pommen/raspi_power_hat/SMPS hat production V1/SMPS hat/prod/SMPS hat-B_Cu.pdf

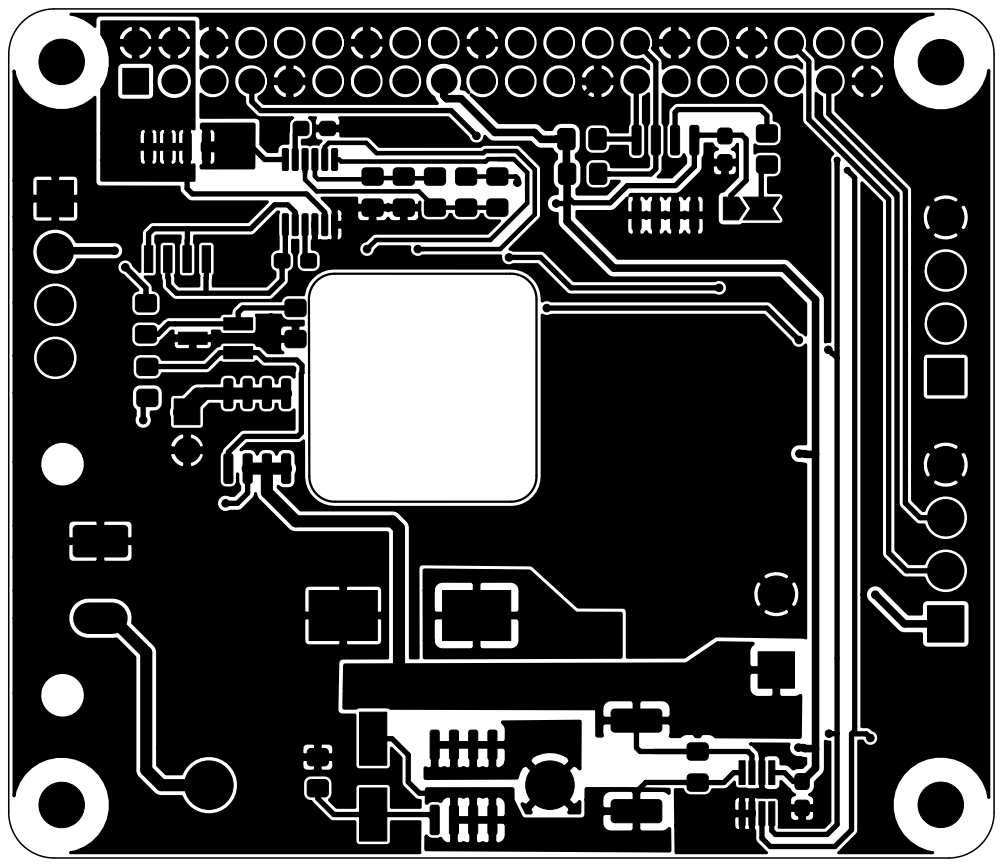
[picture p1: page 1]
