pommen/raspi_power_hat/SMPS hat production V1/SMPS hat/prod/SMPS hat-B_Mask.pdf

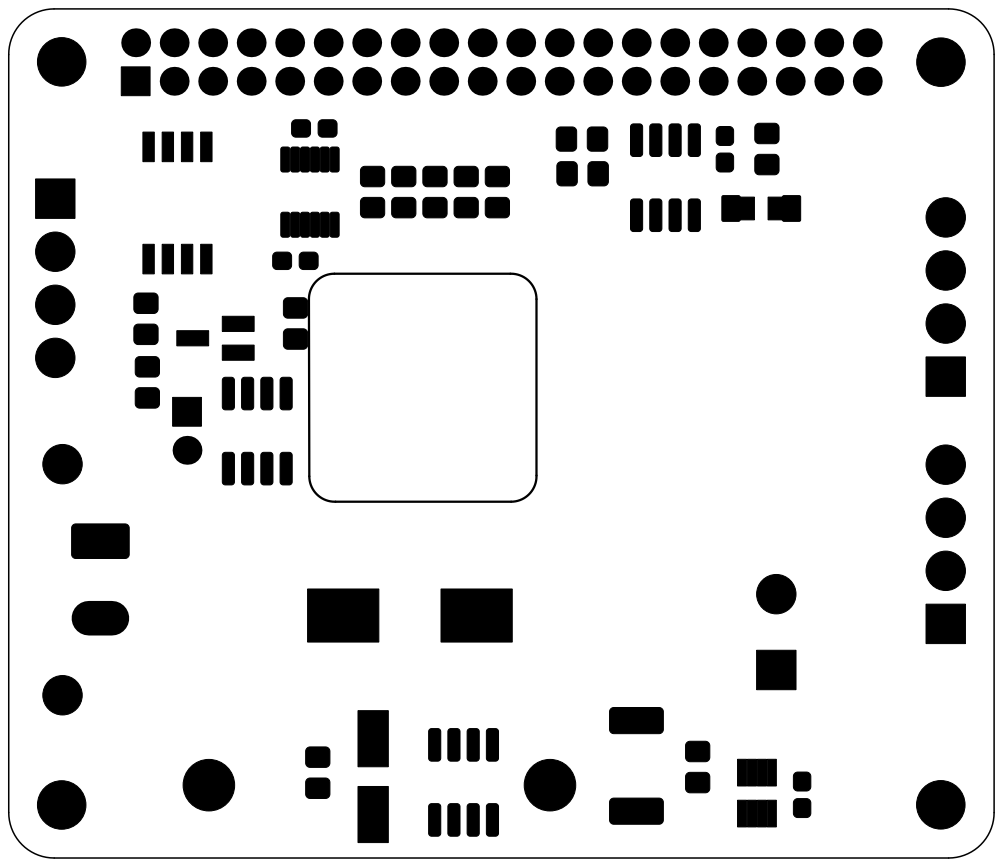
[picture p2: page 1]
