pommen/raspi_power_hat/SMPS hat production V1/SMPS hat/prod/SMPS hat-B_Paste.pdf

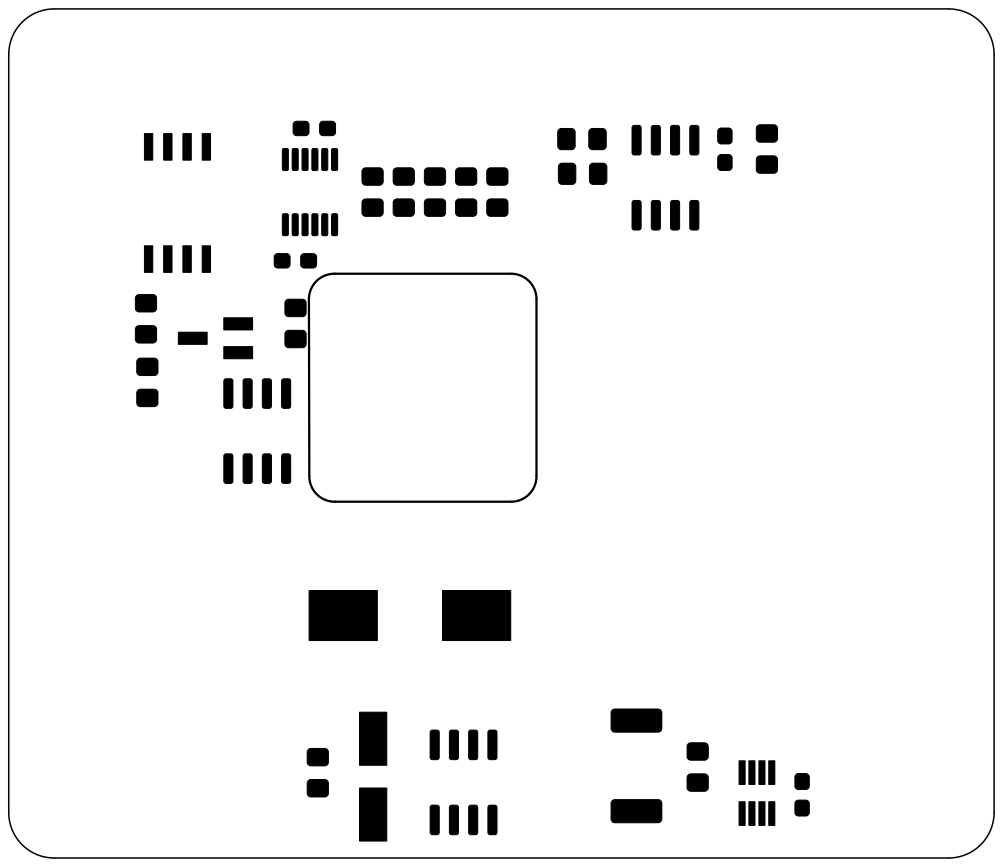
[picture p3: page 1]
