pommen/raspi_power_hat/SMPS hat production V1/SMPS hat/prod/SMPS hat-B_SilkS.pdf

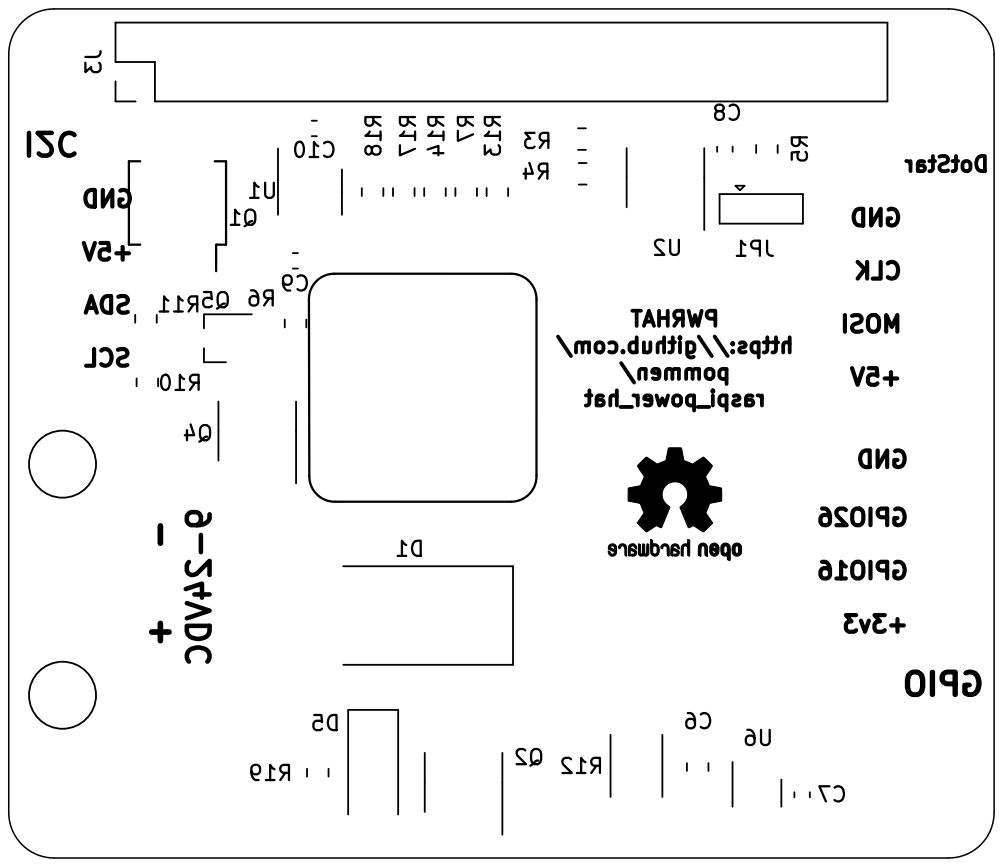
[picture p4: page 1]

https://github.com/ pommen/ raspi_power_hatR12 U6 U2 U1 R19 R18 R17 R14 R13 R11 R10 R7 R6 R5 R4 R3 Q5Q4 Q2 Q1
