pommen/raspi_power_hat/SMPS hat production V1/SMPS hat/prod/SMPS hat-Edge_Cuts.pdf

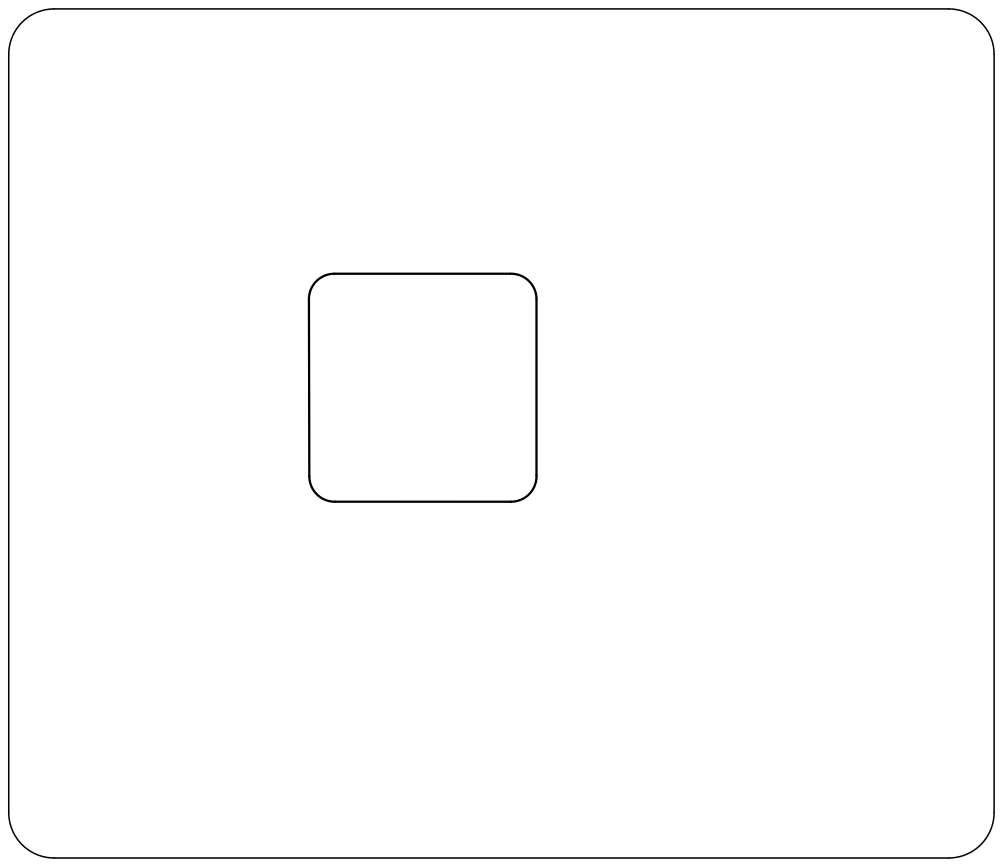
[picture p5: page 1]
