pommen/raspi_power_hat/SMPS hat production V1/SMPS hat/prod/SMPS hat-F_Cu.pdf

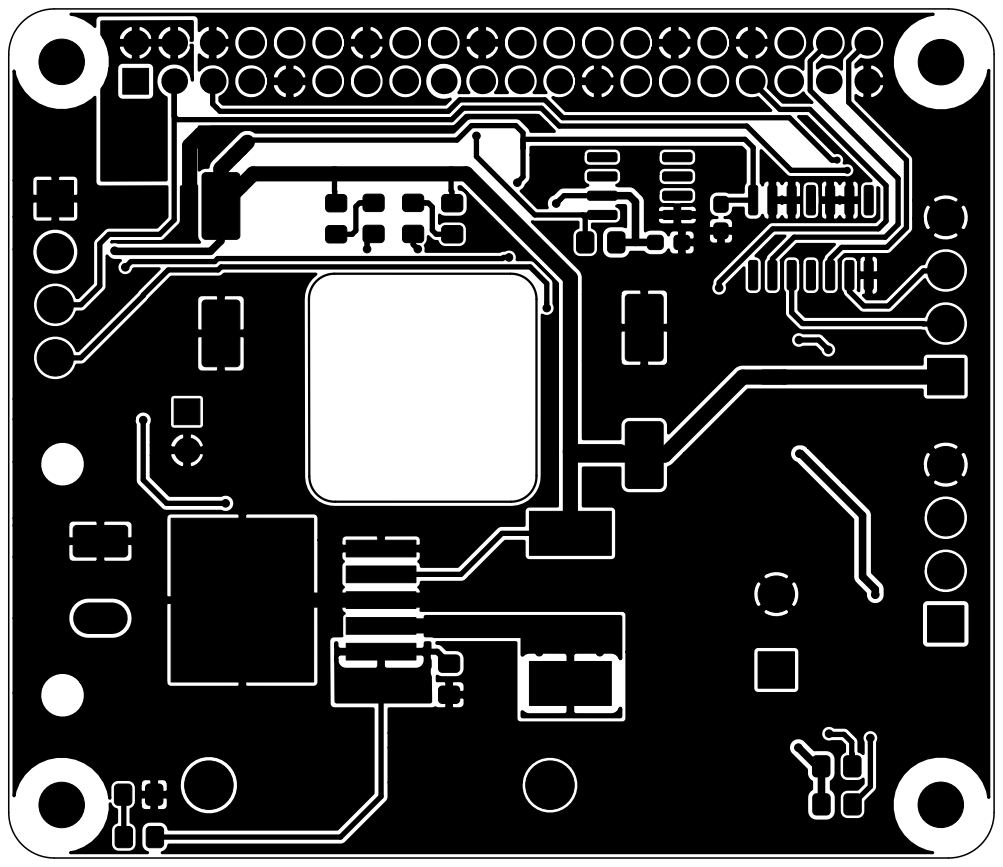
[picture p6: page 1]
