pommen/raspi_power_hat/SMPS hat production V1/SMPS hat/prod/SMPS hat-F_Mask.pdf

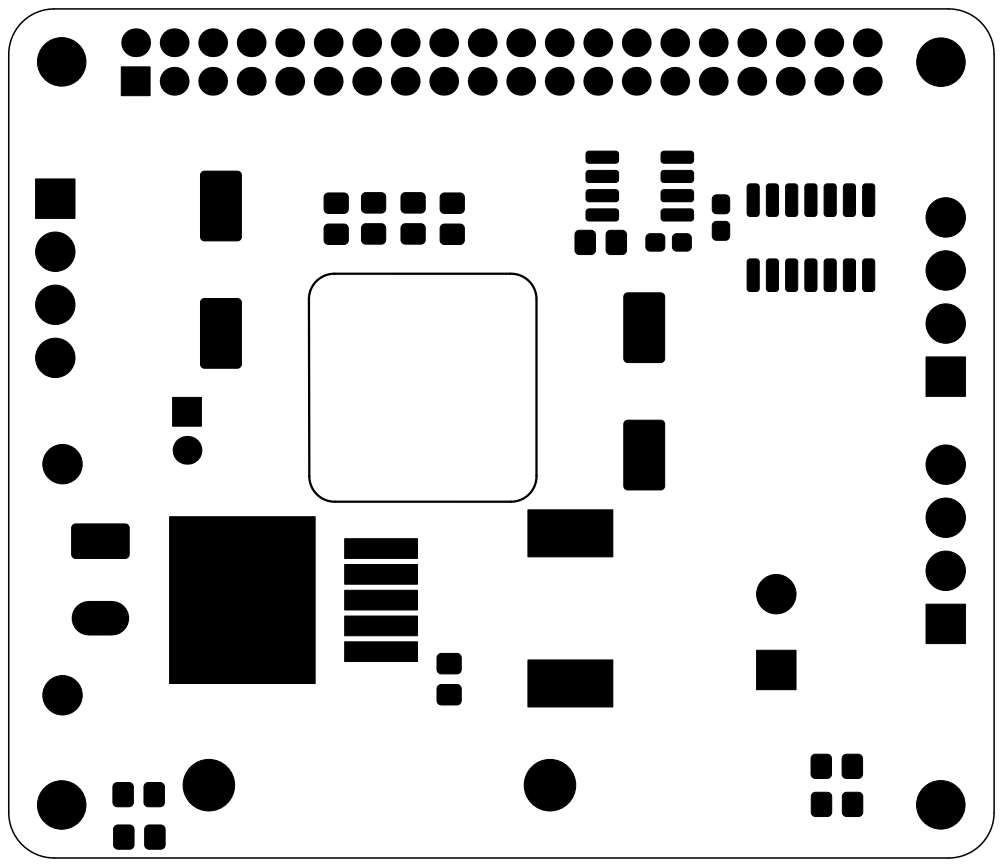
[picture p7: page 1]
