pommen/raspi_power_hat/SMPS hat production V1/SMPS hat/prod/SMPS hat-F_Paste.pdf

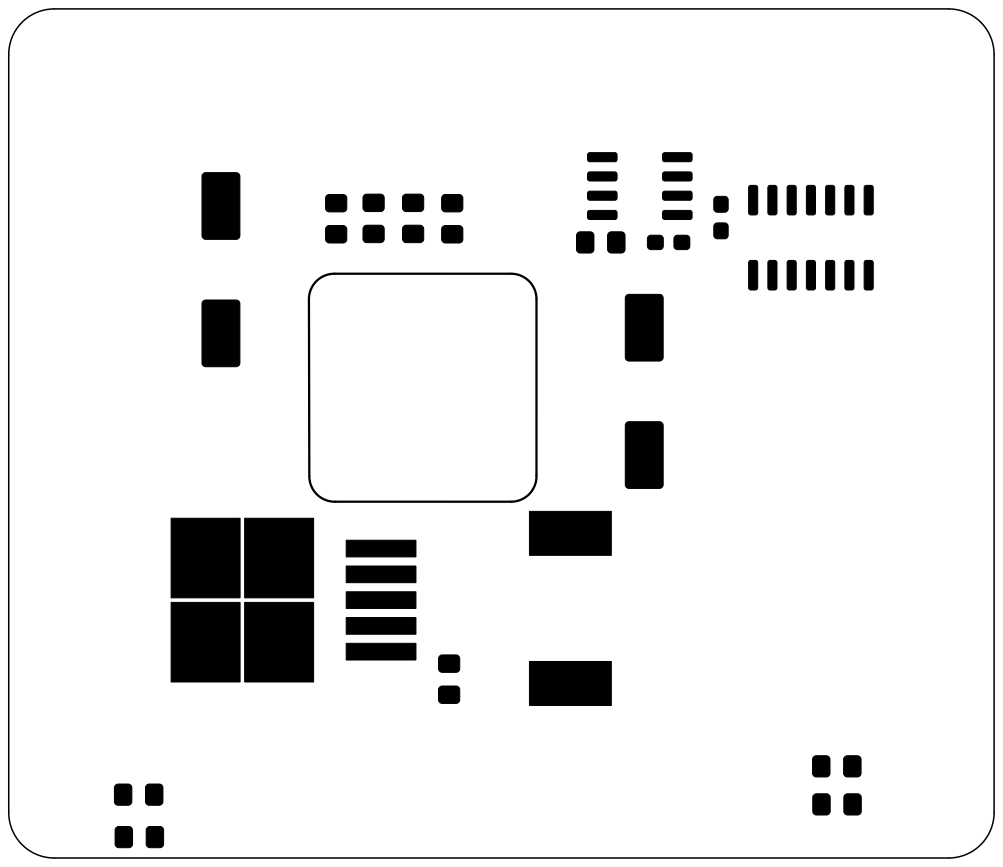
[picture p8: page 1]
