pommen/raspi_power_hat/SMPS hat production V1/SMPS hat/prod/SMPS hat-F_SilkS.pdf

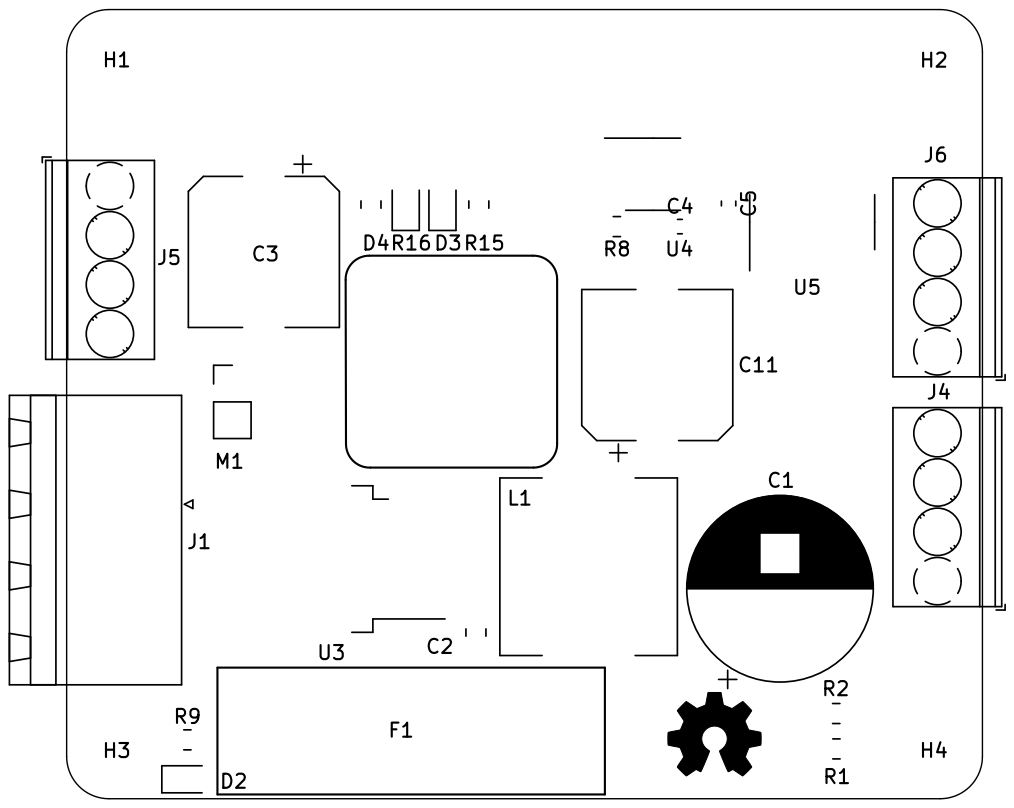
[picture p9: page 1]
