pommen/raspi_power_hat/SMPS hat production V1/SMPS hat/SMPS hat.kicad_pcb

## KiCad design SMPS hat production V1/SMPS hat/SMPS hat.kicad_pcb (2019-09-14)

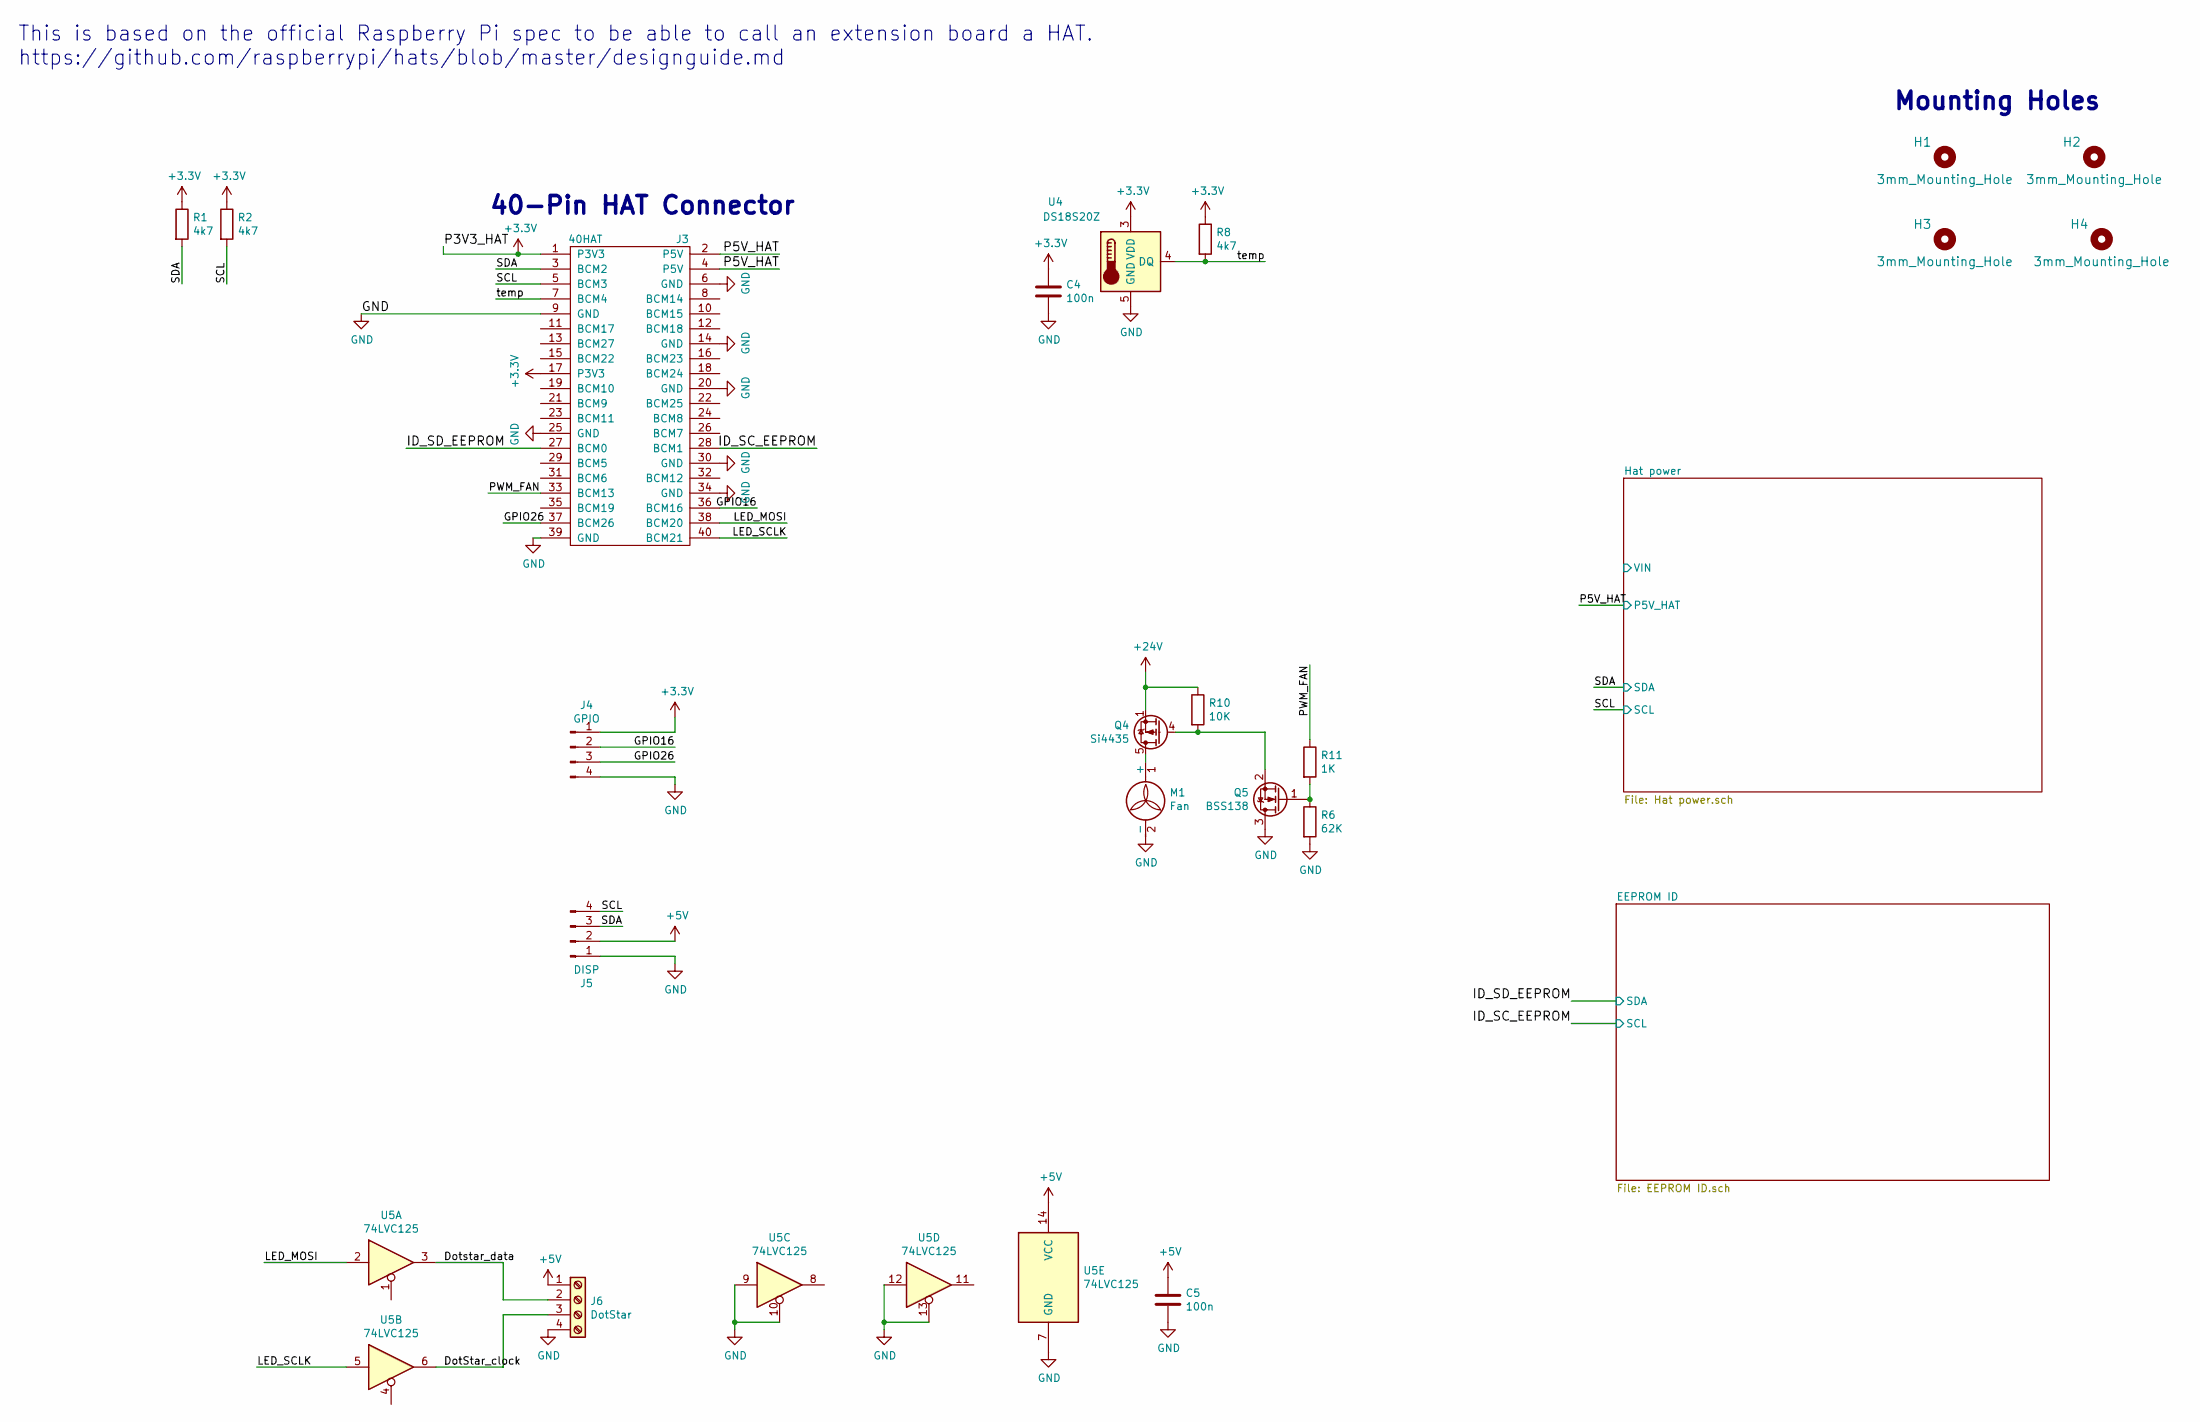
[picture p10: schematic SMPS hat.sch, Raspberry Pi power HAT]

Parts:
C4, C5: 100n; C_0603_1608Metric_Pad1.05x0.95mm_HandSolder
H1, H2, H3, H4: 3mm_Mounting_Hole; NPTH_3mm_ID
J3: 40HAT; PinSocket_2x20_P2.54mm_Vertical
J4: GPIO; TerminalBlock_Phoenix_PT-1,5-4-3.5-H_1x04_P3.50mm_Horizontal
J5: DISP; TerminalBlock_Phoenix_PT-1,5-4-3.5-H_1x04_P3.50mm_Horizontal
J6: DotStar; TerminalBlock_Phoenix_PT-1,5-4-3.5-H_1x04_P3.50mm_Horizontal
M1: Fan; PinHeader_1x02_P2.54mm_Vertical
Q4: Si4435; SOIC-8_3.9x4.9mm_P1.27mm
Q5: BSS138; SOT-23_Handsoldering
R1, R2, R8: 4k7; R_0805_2012Metric_Pad1.15x1.40mm_HandSolder
R6: 62K; R_0805_2012Metric_Pad1.15x1.40mm_HandSolder
R10: 10K; R_0805_2012Metric_Pad1.15x1.40mm_HandSolder
R11: 1K; R_0805_2012Metric_Pad1.15x1.40mm_HandSolder
U4: DS18S20Z; SOIC-8_3.9x4.9mm_P1.27mm
U5: 74LVC125; SOIC-14_3.9x8.7mm_P1.27mm

Connections:
+3V3: C4.1, J3.1 (P3V3), J3.17 (P3V3), J4.1, R1.1, R2.1, R8.1, U4.3 (VDD); also elsewhere on the board
+5V: C5.1, J5.2, J6.1, U5.14 (VCC); also elsewhere on the board
+24V: Q4.1 (S), Q4.2 (S), Q4.3 (S), R10.1; also elsewhere on the board
/DotStar_clock: J6.3, U5.6
/Dotstar_data: J6.2, U5.3
/GPIO16: J3.36 (BCM16), J4.2
/GPIO26: J3.37 (BCM26), J4.3
/ID_SC_EEPROM: J3.28 (BCM1); also elsewhere on the board
/ID_SD_EEPROM: J3.27 (BCM0); also elsewhere on the board
/LED_MOSI: J3.38 (BCM20), U5.2
/LED_SCLK: J3.40 (BCM21), U5.5
/P5V_HAT: J3.2 (P5V), J3.4 (P5V); also elsewhere on the board
/PWM_FAN: J3.33 (BCM13), R11.1
/SCL: J3.5 (BCM3), J5.4, R2.2; also elsewhere on the board
/SDA: J3.3 (BCM2), J5.3, R1.2; also elsewhere on the board
/temp: J3.7 (BCM4), R8.2, U4.4 (DQ)
GND: C4.2, C5.2, J3.6 (GND), J3.9 (GND), J3.14 (GND), J3.20 (GND), J3.25 (GND), J3.30 (GND), J3.34 (GND), J3.39 (GND), J4.4, J5.1, J6.4, M1.2 (-), Q5.3 (D), R6.2, U4.5 (GND), U5.7 (GND), U5.9, U5.10, U5.12, U5.13; also elsewhere on the board
unnamed: M1.1 (+), Q4.5 (D), Q4.6 (D), Q4.7 (D), Q4.8 (D)
unnamed: Q4.4 (G), Q5.2 (S), R10.2
unnamed: Q5.1 (G), R6.1, R11.2

Notes on the sheet:
Mounting Holes
40-Pin HAT Connector
This is based on the official Raspberry Pi spec to be able to call an extension board a HAT. https://github.com/raspberrypi/hats/blob/master/designguide.md

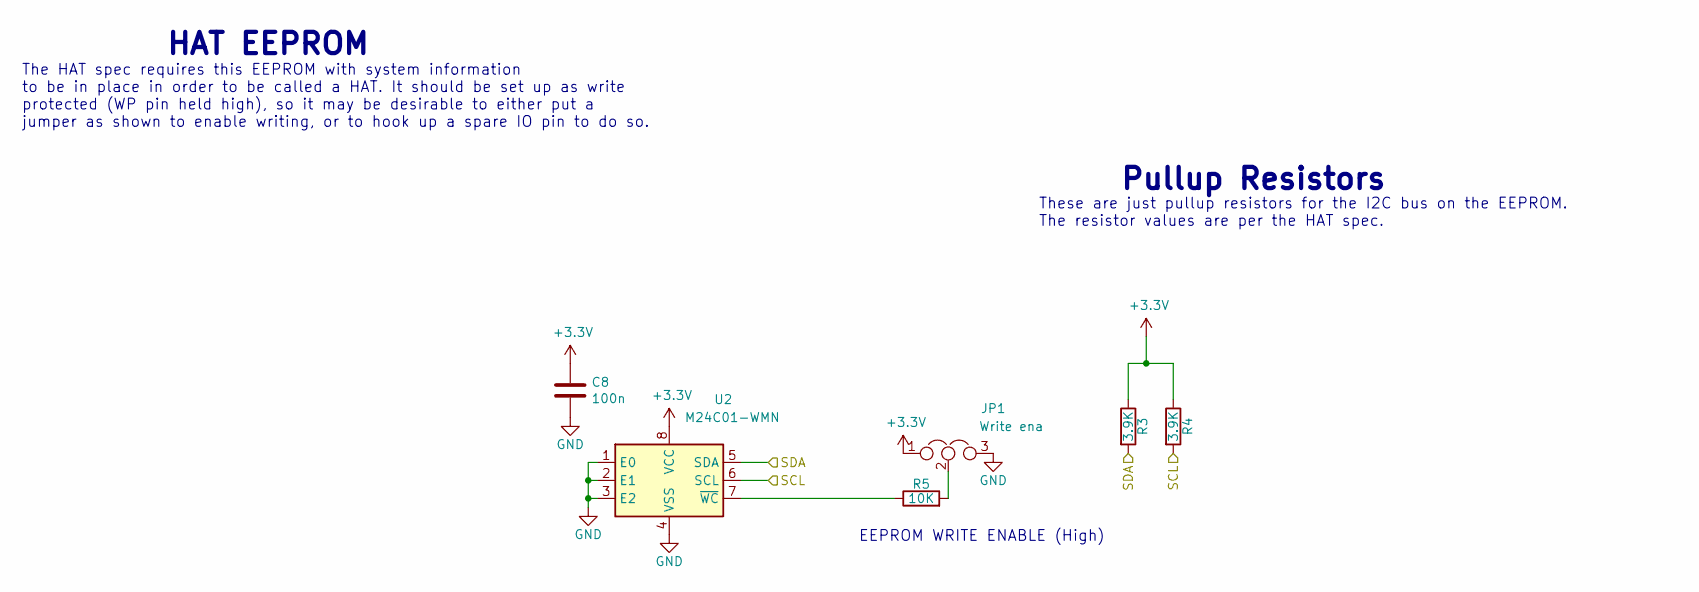
[picture p11: schematic EEPROM ID.sch]

Parts:
C8: 100n; C_0603_1608Metric_Pad1.05x0.95mm_HandSolder
JP1: Write ena; SolderJumper-3_P2.0mm_Open_TrianglePad1.0x1.5mm
R3, R4: 3.9K; R_0805_2012Metric_Pad1.15x1.40mm_HandSolder
R5: 10K; R_0805_2012Metric_Pad1.15x1.40mm_HandSolder
U2: M24C01-WMN; SOIC-8_3.9x4.9mm_P1.27mm

Connections:
+3V3: C8.1, JP1.1, R3.1, R4.1, U2.8 (VCC); also elsewhere on the board
/ID_SC_EEPROM: R4.2, U2.6 (SCL); also elsewhere on the board
/ID_SD_EEPROM: R3.2, U2.5 (SDA); also elsewhere on the board
GND: C8.2, JP1.3, U2.1 (E0), U2.2 (E1), U2.3 (E2), U2.4 (VSS); also elsewhere on the board
unnamed: JP1.2, R5.2
unnamed: R5.1, U2.7 (~WC)

Notes on the sheet:
EEPROM WRITE ENABLE (High)
Pullup Resistors
HAT EEPROM
The HAT spec requires this EEPROM with system information to be in place in order to be called a HAT. It should be set up as write protected (WP pin held high), so it may be desirable to either put a jumper as shown to enable writing, or to hook up a spare IO pin to do so.
These are just pullup resistors for the I2C bus on the EEPROM. The resistor values are per the HAT spec.

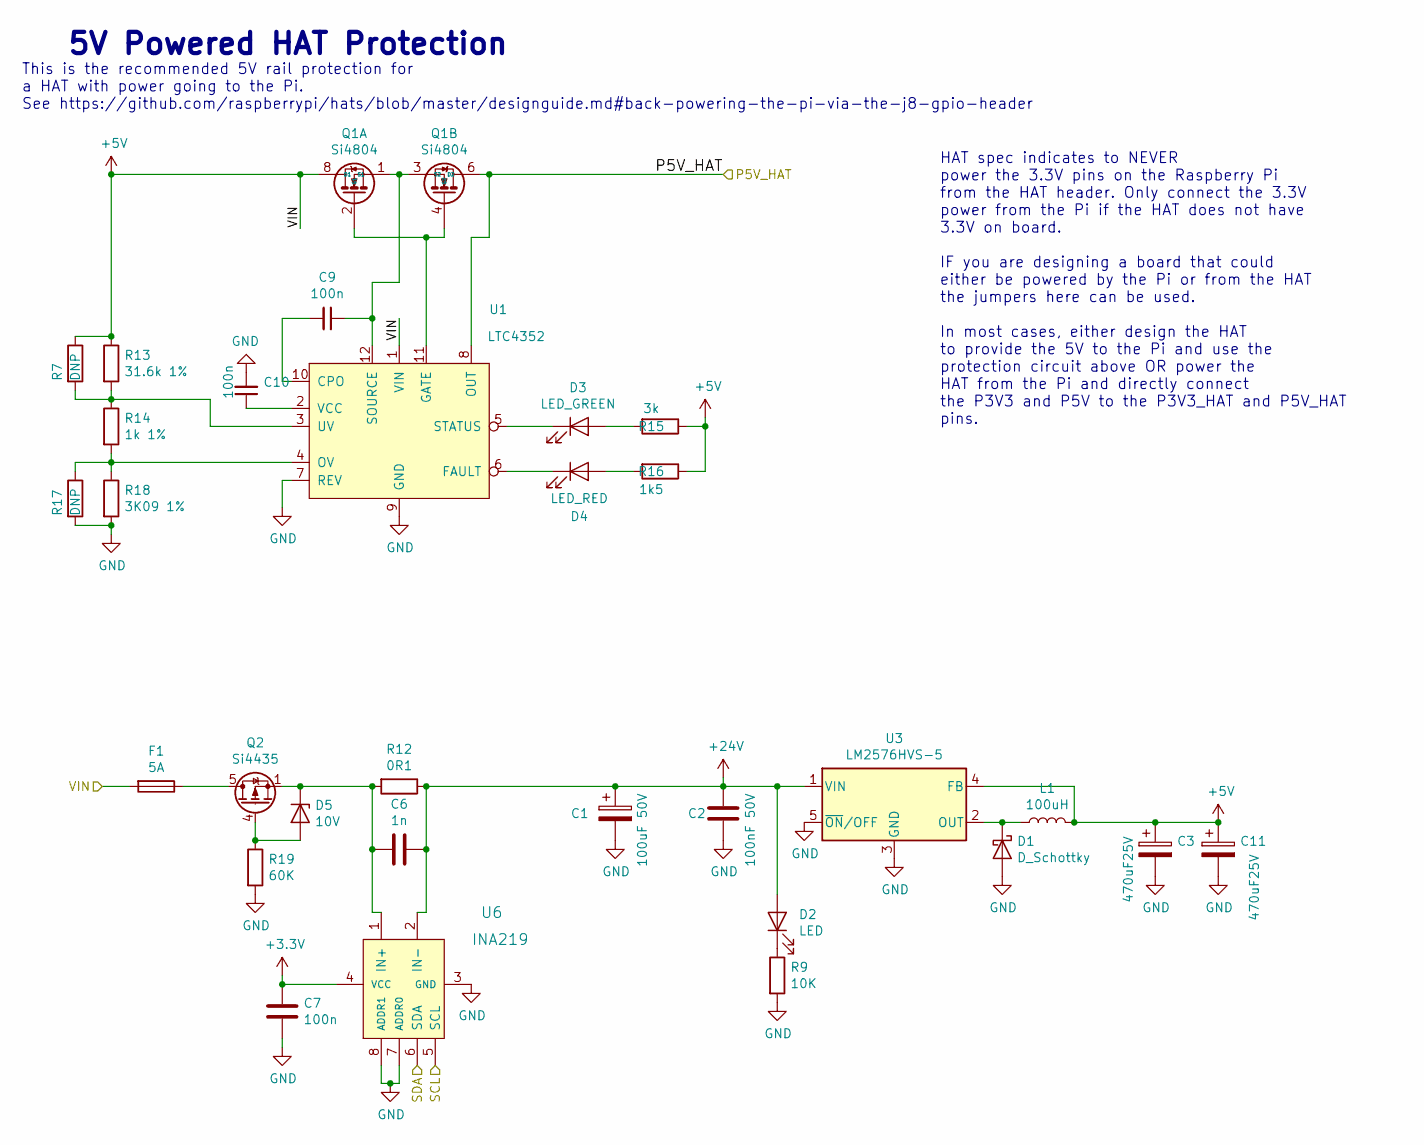
[picture p12: schematic Hat power.sch]

Parts:
C1: 100uF 50V; CP_Radial_D13.0mm_P5.00mm
C2: 100nF 50V; C_0805_2012Metric_Pad1.15x1.40mm_HandSolder
C3, C11: 470uF25V; CP_Elec_10x10.5
C6: 1n; C_0805_2012Metric_Pad1.15x1.40mm_HandSolder
C7, C9, C10: 100n; C_0603_1608Metric_Pad1.05x0.95mm_HandSolder
D1: D_Schottky; D_SMC_Handsoldering
D2: LED; LED_0805_2012Metric_Pad1.15x1.40mm_HandSolder
D3: LED_GREEN; LED_0805_2012Metric_Pad1.15x1.40mm_HandSolder
D4: LED_RED; LED_0805_2012Metric_Pad1.15x1.40mm_HandSolder
D5: 10V; D_SMA_Handsoldering
F1: 5A; Fuse_holser_Plastic_ebay
L1: 100uH; L_12x12mm_H8mm
Q1: Si4804; SO-8_5.3x6.2mm_P1.27mm
Q2: Si4435; SOIC-8_3.9x4.9mm_P1.27mm
R7, R17: DNP; R_0805_2012Metric_Pad1.15x1.40mm_HandSolder
R9: 10K; R_0805_2012Metric_Pad1.15x1.40mm_HandSolder
R12: 0R1; R_2512_6332Metric_Pad1.52x3.35mm_HandSolder
R13: 31.6k 1%; R_0805_2012Metric_Pad1.15x1.40mm_HandSolder
R14: 1k 1%; R_0805_2012Metric_Pad1.15x1.40mm_HandSolder
R15: 3k; R_0805_2012Metric_Pad1.15x1.40mm_HandSolder
R16: 1k5; R_0805_2012Metric_Pad1.15x1.40mm_HandSolder
R18: 3K09 1%; R_0805_2012Metric_Pad1.15x1.40mm_HandSolder
R19: 60K; R_0805_2012Metric_Pad1.15x1.40mm_HandSolder
U1: LTC4352; MSOP-12_3x4mm_P0.65mm
U3: LM2576HVS-5; TO-263-5_TabPin3
U6: INA219; SOT-23-8_Handsoldering

Connections:
+3V3: C7.1, U6.4 (VCC); also elsewhere on the board
+5V: C3.1, C11.1, L1.2, Q1.8 (D1), R7.1, R13.1, R15.1, R16.1, U1.1 (VIN), U3.4 (FB); also elsewhere on the board
+24V: C1.1, C2.1, C6.1, D2.2 (A), R12.1, U3.1 (VIN), U6.2 (IN-); also elsewhere on the board
/Hat power/VIN: F1.2; also elsewhere on the board
/P5V_HAT: Q1.5 (D2), Q1.6 (D2), Q1.7 (D1), U1.8 (OUT); also elsewhere on the board
/SCL: U6.5 (SCL); also elsewhere on the board
/SDA: U6.6 (SDA); also elsewhere on the board
GND: C1.2, C2.2, C3.2, C7.2, C10.2, C11.2, D1.2 (A), R9.2, R17.2, R18.2, R19.2, U1.7 (REV), U1.9 (GND), U3.3 (GND), U3.5 (~ON~/OFF), U6.3 (GND), U6.7 (ADDR0), U6.8 (ADDR1); also elsewhere on the board
unnamed: C6.2, D5.1 (K), Q2.1 (S), Q2.2 (S), Q2.3 (S), R12.2, U6.1 (IN+)
unnamed: C9.1, Q1.1 (S1), Q1.3 (S2), U1.12 (SOURCE)
unnamed: C9.2, U1.10 (CPO)
unnamed: C10.1, U1.2 (VCC)
unnamed: D1.1 (K), L1.1, U3.2 (OUT)
unnamed: D2.1 (K), R9.1
unnamed: D3.1 (K), U1.5 (STATUS)
unnamed: D3.2 (A), R15.2
unnamed: D4.1 (K), U1.6 (FAULT)
unnamed: D4.2 (A), R16.2
unnamed: D5.2 (A), Q2.4 (G), R19.1
unnamed: F1.1, Q2.5 (D), Q2.6 (D), Q2.7 (D), Q2.8 (D)
unnamed: Q1.2 (G1), Q1.4 (G2), U1.11 (GATE)
unnamed: R7.2, R13.2, R14.1, U1.3 (UV)
unnamed: R14.2, R17.1, R18.1, U1.4 (OV)

Notes on the sheet:
5V Powered HAT Protection
This is the recommended 5V rail protection for a HAT with power going to the Pi. See https://github.com/raspberrypi/hats/blob/master/designguide.md#back-powering-the-pi-via-the-j8-gpio-header
HAT spec indicates to NEVER power the 3.3V pins on the Raspberry Pi from the HAT header. Only connect the 3.3V power from the Pi if the HAT does not have 3.3V on board. IF you are designing a board that could either be powered by the Pi or from the HAT the jumpers here can be used. In most cases, e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

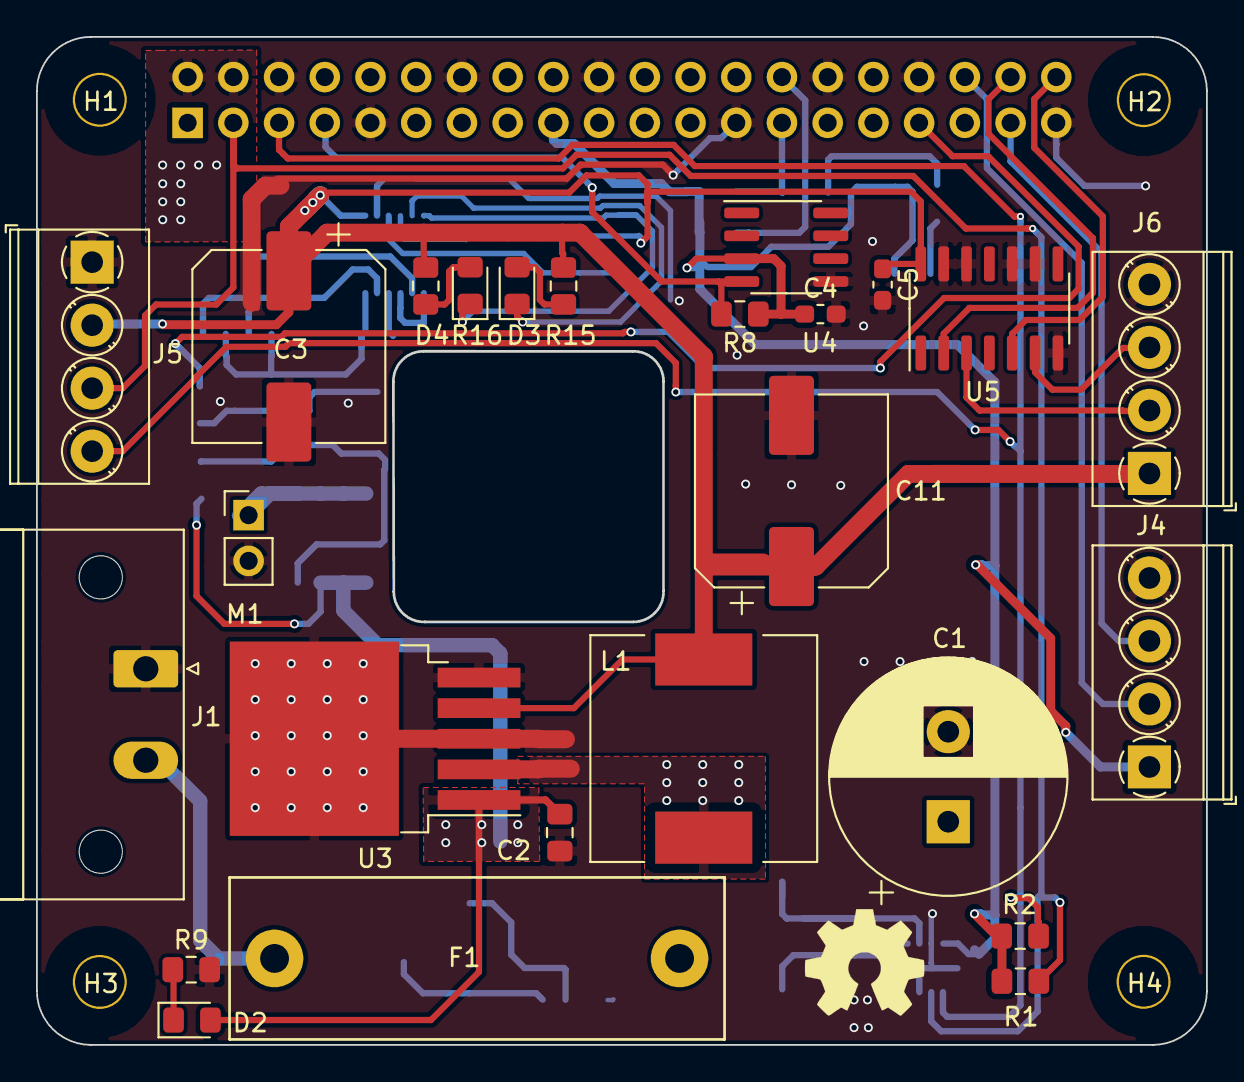
[picture p13: board SMPS hat.kicad_pcb from above]

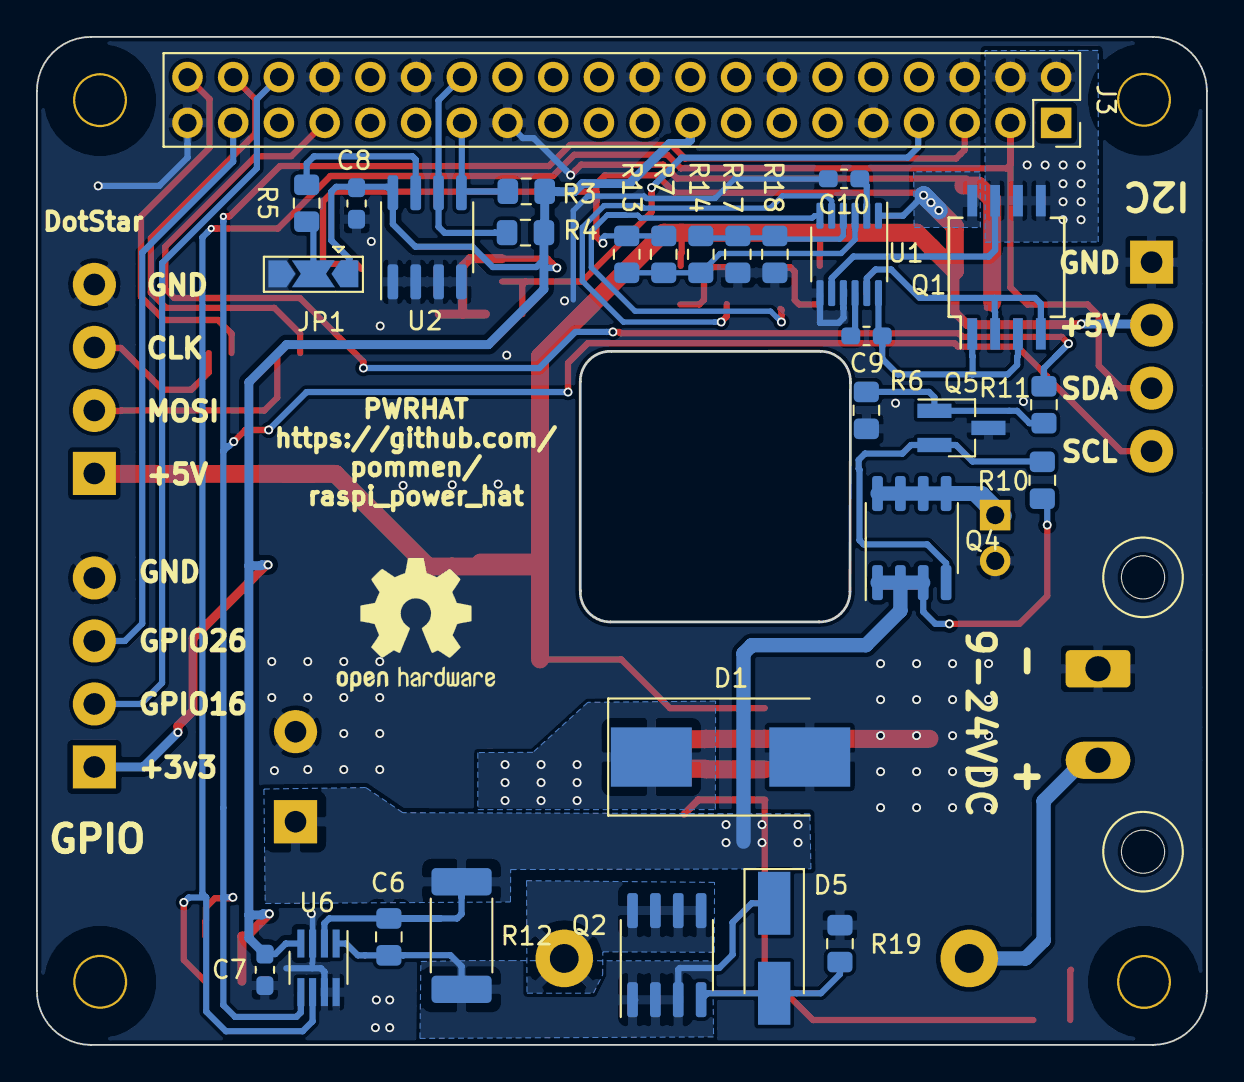
[picture p14: board SMPS hat.kicad_pcb from below]

Board: 2 copper layers, 65.0 x 56.0 mm, 58 parts (29 on the bottom side), 38 nets.

Other parts of the board:
J1: Vin; PhoenixContact_MSTB_2,5_2-GF-5,08_1x02_P5.08mm_Horizontal_T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

Their connections:
/Hat power/VIN: J1.2; also elsewhere on the board
GND: J1.1; also elsewhere on the board
